aayushgrover0802/quadruped-12DOF-ROS-SIM-REAL/README.md

# quadruped_ws

ROS 2 workspace for the quadruped. Everything lives in [`src/QuadPkg`](src/QuadPkg/README.md);
documentation is in [`src/QuadPkg/docs`](src/QuadPkg/docs/README.md).

```bash
cd ~/quadruped_ws && colcon build --packages-select QuadPkg && source install/setup.bash
```
