aayushgrover0802/quadruped-12DOF-ROS-SIM-REAL/servo_log.txt

servo_monitor  [REAL ROBOT (hardware_bridge debug topics)]   00:09:39
controller state: STAND   motors enabled: False   battery: 11.2 V
last msg  /joint_command  0.0s ago | /debug/servo_command  0.1s ago | /debug/servo_feedback  0.1s ago | /joint_states  0.0s ago
!! NOT SENDING: motors OFF (press M in teleop)

joint        id   ctrl°   sent° ticks> <ticks   meas°   err°  load%  °C     V  flags
------------------------------------------------------------------------------------
FL_HipRoll    3    +0.0       -      -   2096    +0.0      -     -4  37  11.2  TQ0
FL_ThighP     2    -0.0       -      -   2208    +0.0      -     -5  45  11.1  TQ0
FL_KneeP      1    +0.0       -      -   2006    +0.0      -     +5  41  11.2  TQ0
FR_HipRoll    6    +0.0       -      -   1994    +0.0      -     +4  38  11.1  TQ0
FR_ThighP     5    -0.0       -      -   1924    -0.0      -     +7  36  11.2  TQ0
FR_KneeP      4    +0.0       -      -   2212    -0.0      -     +0  38  11.1  TQ0
BL_HipRoll    9    +0.0       -      -   2025    -0.0      -     +6  37  11.2  TQ0
BL_ThighP     8    -0.0       -      -   2341    +0.0      -     -7  37  11.2  TQ0
BL_KneeP      7    +0.0       -      -   2060    +0.0      -     +3  36  11.1  TQ0
BR_HipRoll   12    +0.0       -      -   2059    -0.0      -     -6  38  11.2  TQ0
BR_ThighP    11    -0.0       -      -   1783    -0.1      -     +6  45  11.1  TQ0
BR_KneeP     10    +0.0       -      -   2000    -0.0      -     -3  39  11.1  TQ0

(Ctrl-C to quit)
servo_monitor  [REAL ROBOT (hardware_bridge debug topics)]   00:09:40
controller state: STAND   motors enabled: False   battery: 11.2 V
last msg  /joint_command  0.0s ago | /debug/servo_command  0.1s ago | /debug/servo_feedback  0.1s ago | /joint_states  0.0s ago
!! NOT SENDING: motors OFF (press M in teleop)

joint        id   ctrl°   sent° ticks> <ticks   meas°   err°  load%  °C     V  flags
------------------------------------------------------------------------------------
FL_HipRoll    3    +0.0       -      -   2096    +0.0      -     -4  37  11.2  TQ0
FL_ThighP     2    -0.0       -      -   2208    +0.0      -     -5  45  11.1  TQ0
FL_KneeP      1    +0.0       -      -   2006    +0.0      -     +5  41  11.2  TQ0
FR_HipRoll    6    +0.0       -      -   1994    +0.0      -     +4  38  11.1  TQ0
FR_ThighP     5    -0.0       -      -   1924    -0.0      -     +7  36  11.2  TQ0
FR_KneeP      4    +0.0       -      -   2212    -0.0      -     +0  38  11.2  TQ0
BL_HipRoll    9    +0.0       -      -   2025    -0.0      -     +6  37  11.2  TQ0
BL_ThighP     8    -0.0       -      -   2341    +0.0      -     -7  37  11.2  TQ0
BL_KneeP      7    +0.0       -      -   2060    +0.0      -     +3  36  11.1  TQ0
BR_HipRoll   12    +0.0       -      -   2059    -0.0      -     -6  38  11.2  TQ0
BR_ThighP    11    -0.0       -      -   1783    -0.1      -     +6  45  11.1  TQ0
BR_KneeP     10    +0.0       -      -   2000    -0.0      -     -3  39  11.1  TQ0

(Ctrl-C to quit)
servo_monitor  [REAL ROBOT (hardware_bridge debug topics)]   00:09:41
controller state: STAND   motors enabled: False   battery: 11.2 V
last msg  /joint_command  0.0s ago | /debug/servo_command  0.1s ago | /debug/servo_feedback  0.1s ago | /joint_states  0.0s ago
!! NOT SENDING: motors OFF (press M in teleop)

joint        id   ctrl°   sent° ticks> <ticks   meas°   err°  load%  °C     V  flags
------------------------------------------------------------------------------------
FL_HipRoll    3    +0.0       -      -   2096    +0.0      -     -4  37  11.2  TQ0
FL_ThighP     2    -0.0       -      -   2208    +0.0      -     -5  45  11.1  TQ0
FL_KneeP      1    +0.0       -      -   2006    +0.0      -     +5  41  11.1  TQ0
FR_HipRoll    6    +0.0       -      -   1994    +0.0      -     +4  38  11.1  TQ0
FR_ThighP     5    -0.0       -      -   1924    -0.0      -     +7  36  11.2  TQ0
FR_KneeP      4    +0.0       -      -   2212    -0.0      -     +0  38  11.2  TQ0
BL_HipRoll    9    +0.0       -      -   2025    -0.0      -     +6  37  11.2  TQ0
BL_ThighP     8    -0.0       -      -   2341    +0.0      -     -7  37  11.2  TQ0
BL_KneeP      7    +0.0       -      -   2060    +0.0      -     +3  36  11.2  TQ0
BR_HipRoll   12    +0.0       -      -   2059    -0.0      -     -6  38  11.2  TQ0
BR_ThighP    11    -0.0       -      -   1783    -0.1      -     +6  45  11.1  TQ0
BR_KneeP     10    +0.0       -      -   2000    -0.0      -     -3  39  11.1  TQ0

(Ctrl-C to quit)
servo_monitor  [REAL ROBOT (hardware_bridge debug topics)]   00:09:42
controller state: STAND   motors enabled: False   battery: 11.1 V
last msg  /joint_command  0.0s ago | /debug/servo_command  0.1s ago | /debug/servo_feedback  0.1s ago | /joint_states  0.0s ago
!! NOT SENDING: motors OFF (press M in teleop)

joint        id   ctrl°   sent° ticks> <ticks   meas°   err°  load%  °C     V  flags
------------------------------------------------------------------------------------
FL_HipRoll    3    +0.0       -      -   2096    +0.0      -     -4  37  11.2  TQ0
FL_ThighP     2    -0.0       -      -   2208    +0.0      -     -5  45  11.1  TQ0
FL_KneeP      1    +0.0       -      -   2006    +0.0      -     +5  41  11.1  TQ0
FR_HipRoll    6    +0.0       -      -   1994    +0.0      -     +4  38  11.1  TQ0
FR_ThighP     5    -0.0       -      -   1924    -0.0      -     +7  37  11.2  TQ0
FR_KneeP      4    +0.0       -      -   2212    -0.0      -     +0  38  11.1  TQ0
BL_HipRoll    9    +0.0       -      -   2025    -0.0      -     +6  37  11.2  TQ0
BL_ThighP     8    -0.0       -      -   2341    +0.0      -     -7  37  11.2  TQ0
BL_KneeP      7    +0.0       -      -   2060    +0.0      -     +3  36  11.2  TQ0
BR_HipRoll   12    +0.0       -      -   2059    -0.0      -     -6  38  11.2  TQ0
BR_ThighP    11    -0.0       -      -   1783    -0.1      -     +6  45  11.1  TQ0
BR_KneeP     10    +0.0       -      -   2000    -0.0      -     -3  39  11.1  TQ0

(Ctrl-C to quit)
servo_monitor  [REAL ROBOT (hardware_bridge debug topics)]   00:09:43
controller state: STAND   motors enabled: True   battery: 11.1 V
last msg  /joint_command  0.0s ago | /debug/servo_command  0.1s ago | /debug/servo_feedback  0.1s ago | /joint_states  0.0s ago

joint        id   ctrl°   sent° ticks> <ticks   meas°   err°  load%  °C     V  flags
------------------------------------------------------------------------------------
FL_HipRoll    3    +0.0    +0.0   2096   2095    -0.1   +0.1     +0  37  11.2  
FL_ThighP     2    -0.0    -0.0   2208   2207    -0.1   +0.1     +0  45  11.2  
FL_KneeP      1    +0.0    +0.0   2006   2006    +0.0   +0.0     +0  41  11.2  
FR_HipRoll    6    +0.0    +0.0   1994   1994    +0.0   +0.0     +0  38  11.2  
FR_ThighP     5    -0.0    -0.0   1924   1927    -0.3   +0.2     +3  36  11.3  
FR_KneeP      4    +0.0    +0.0   2212   2212    -0.0   +0.0     +0  38  11.2  
BL_HipRoll    9    +0.0    +0.0   2025   2027    -0.2   +0.2     +2  37  11.3  
BL_ThighP     8    -0.0    -0.0   2341   2339    -0.2   +0.1     -2  37  11.2  
BL_KneeP      7    +0.0    +0.0   2060   2060    +0.0   +0.0     +0  36  11.2  
BR_HipRoll   12    +0.0    +0.0   2059   2058    +0.1   -0.1     +0  38  11.3  
BR_ThighP    11    -0.0    -0.0   1782   1785    -0.3   +0.2     +3  45  11.2  
BR_KneeP     10    +0.0    +0.0   2000   1999    +0.1   -0.1     +0  39  11.2  

(Ctrl-C to quit)
servo_monitor  [REAL ROBOT (hardware_bridge debug topics)]   00:09:44
controller state: STAND   motors enabled: True   battery: 11.2 V
last msg  /joint_command  0.0s ago | /debug/servo_command  0.1s ago | /debug/servo_feedback  0.1s ago | /joint_states  0.0s ago

joint        id   ctrl°   sent° ticks> <ticks   meas°   err°  load%  °C     V  flags
------------------------------------------------------------------------------------
FL_HipRoll    3    +0.0    +0.0   2096   2095    -0.1   +0.1     +0  37  11.2  
FL_ThighP     2    -0.0    -0.0   2208   2207    -0.1   +0.1     +0  45  11.2  
FL_KneeP      1    +0.0    +0.0   2006   2006    +0.0   +0.0     +0  41  11.2  
FR_HipRoll    6    +0.0    +0.0   1994   1994    +0.0   +0.0     +0  38  11.2  
FR_ThighP     5    -0.0    -0.0   1924   1927    -0.3   +0.2     +3  36  11.3  
FR_KneeP      4    +0.0    +0.0   2212   2212    -0.0   +0.0     +0  38  11.2  
BL_HipRoll    9    +0.0    +0.0   2025   2027    -0.2   +0.2     +2  37  11.3  
BL_ThighP     8    -0.0    -0.0   2341   2339    -0.2   +0.1     -2  37  11.2  
BL_KneeP      7    +0.0    +0.0   2060   2060    +0.0   +0.0     +0  36  11.2  
BR_HipRoll   12    +0.0    +0.0   2059   2058    +0.1   -0.1     +0  38  11.3  
BR_ThighP    11    -0.0    -0.0   1782   1785    -0.3   +0.2     +3  45  11.2  
BR_KneeP     10    +0.0    +0.0   2000   1999    +0.1   -0.1     +0  38  11.2  

(Ctrl-C to quit)
servo_monitor  [REAL ROBOT (hardware_bridge debug topics)]   00:09:45
controller state: WALK   motors enabled: True   battery: 11.2 V
last msg  /joint_command  0.0s ago | /debug/servo_command  0.1s ago | /debug/servo_feedback  0.1s ago | /joint_states  0.0s ago

joint        id   ctrl°   sent° ticks> <ticks   meas°   err°  load%  °C     V  flags
------------------------------------------------------------------------------------
FL_HipRoll    3    +0.0    +0.0   2096   2093    -0.3   +0.3     -3  37  11.0  
FL_ThighP     2    -4.7    -4.5   2156   2174    -3.0   -1.5     +6  45  11.0  SLEW
FL_KneeP      1    +3.7    +1.9   2028   2009    +0.3   +1.7     -5  41  11.0  SLEW
FR_HipRoll    6    +0.0    +0.0   1994   2001    +0.6   -0.6     +6  39  10.9  
FR_ThighP     5    +1.2    +1.2   1910   1932    -0.7   +1.9    +27  36  10.9  
FR_KneeP      4    -0.1    -0.1   2214   2172    +3.5   -3.7    -25  38  10.9  
BL_HipRoll    9    +0.0    +0.0   2025   2031    -0.5   +0.5     +6  37  11.0  
BL_ThighP     8    +1.2    +1.2   2355   2332    -0.8   +2.0    -27  37  11.0  
BL_KneeP      7    -0.2    -0.2   2057   2106    +4.0   -4.3    +27  36  11.0  
BR_HipRoll   12    +0.0    +0.0   2059   2058    +0.1   -0.1     +2  38  11.0  
BR_ThighP    11    -4.7    -4.5   1833   1816    -3.0   -1.5     -7  45  10.9  SLEW
BR_KneeP     10    +3.0    +1.6   1982   1996    +0.3   +1.3     +2  39  11.0  SLEW

(Ctrl-C to quit)
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
BR_HipRoll   12    +0.0    +0.0   2059   2054    +0.4   -0.4     -5  38  11.1  
BR_ThighP    11    -0.0    -0.0   1782   1785    -0.3   +0.2     +3  44  11.0  
BR_KneeP     10    +0.0    +0.0   2000   1981    +1.7   -1.7    -16  39  11.1  

(Ctrl-C to quit)
