aayushgrover0802/quadruped-12DOF-ROS-SIM-REAL/src/QuadPkg/isaac/scenes/.thumbs/256x256/NewQuad.usd.png

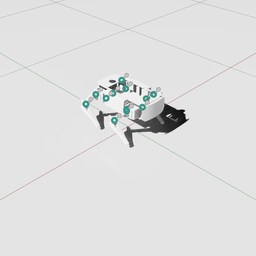
src/QuadPkg/isaac/scenes/.thumbs/256x256/NewQuad.usd.png
