aayushgrover0802/quadruped-12DOF-ROS-SIM-REAL/src/QuadPkg/urdf/meshes/base_link.STL

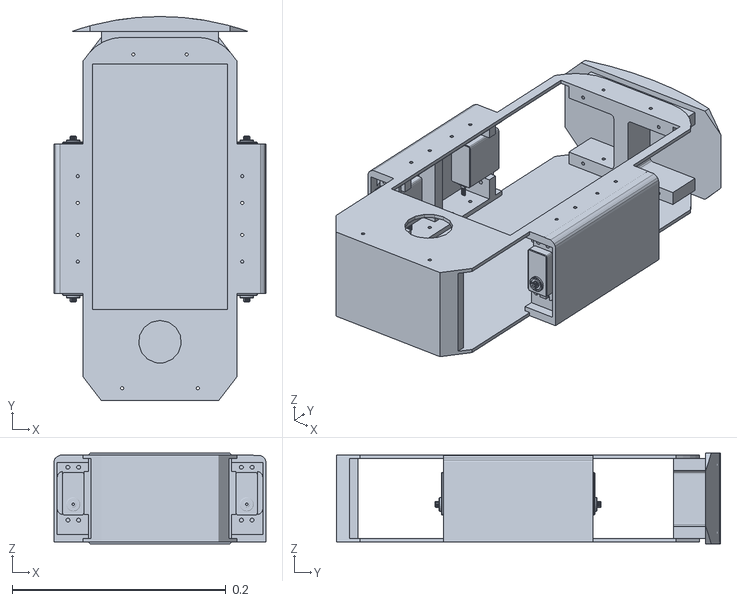
[picture p2: CAD file, 2026-10-12]
src/QuadPkg/urdf/meshes/base_link.STL
0.198 x 0.36 x 0.085
