aayushgrover0802/quadruped-12DOF-ROS-SIM-REAL/src/QuadPkg/urdf/meshes/BL_Thigh.STL

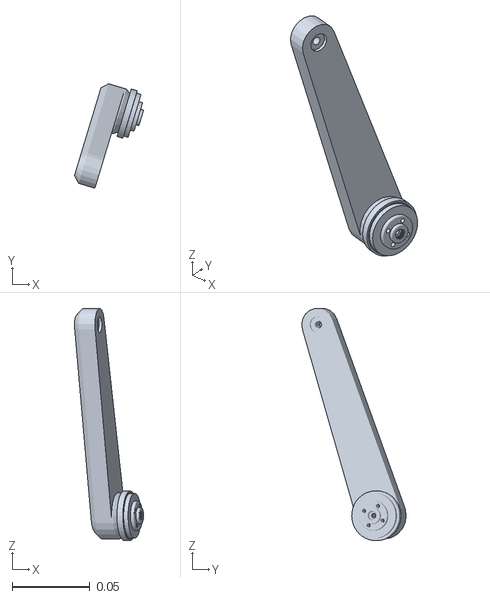
[picture p3: CAD file, 2026-10-12]
src/QuadPkg/urdf/meshes/BL_Thigh.STL
0.0446 x 0.0674 x 0.15
