aayushgrover0802/quadruped-12DOF-ROS-SIM-REAL/src/QuadPkg/urdf/meshes/BR_Hip.STL

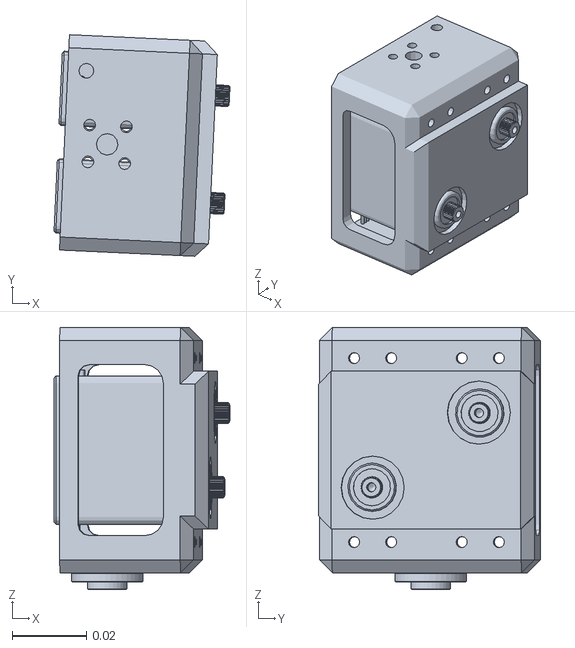
[picture p4: CAD file, 2026-10-12]
src/QuadPkg/urdf/meshes/BR_Hip.STL
0.0473 x 0.0596 x 0.0705
