aayushgrover0802/quadruped-12DOF-ROS-SIM-REAL/src/QuadPkg/urdf/meshes/FL_Thigh.STL

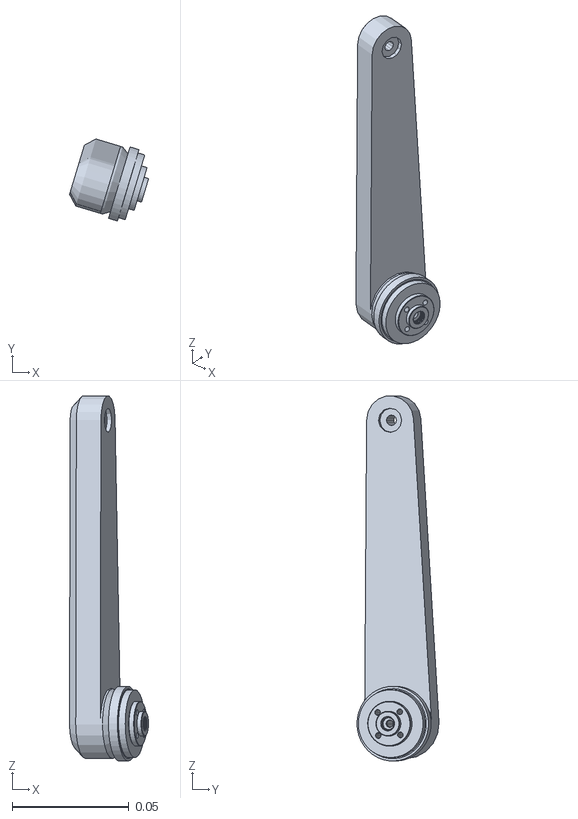
[picture p5: CAD file, 2026-10-12]
src/QuadPkg/urdf/meshes/FL_Thigh.STL
0.0338 x 0.0351 x 0.156
