aayushgrover0802/quadruped-12DOF-ROS-SIM-REAL/src/QuadPkg/urdf/meshes/FR_Knee.STL

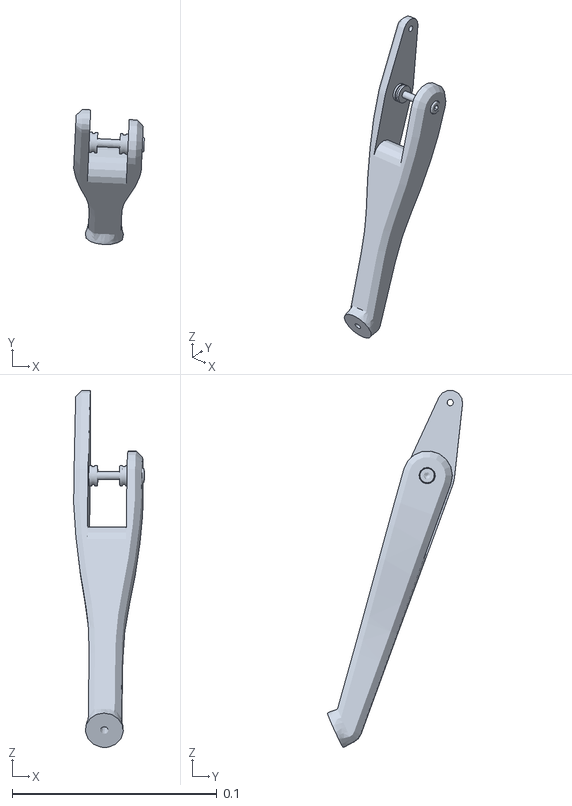
[picture p6: CAD file, 2026-10-12]
src/QuadPkg/urdf/meshes/FR_Knee.STL
0.0345 x 0.066 x 0.174
