aayushgrover0802/quadruped-12DOF-ROS-SIM-REAL/src/QuadPkg/urdf/meshes/BR_Foot.STL

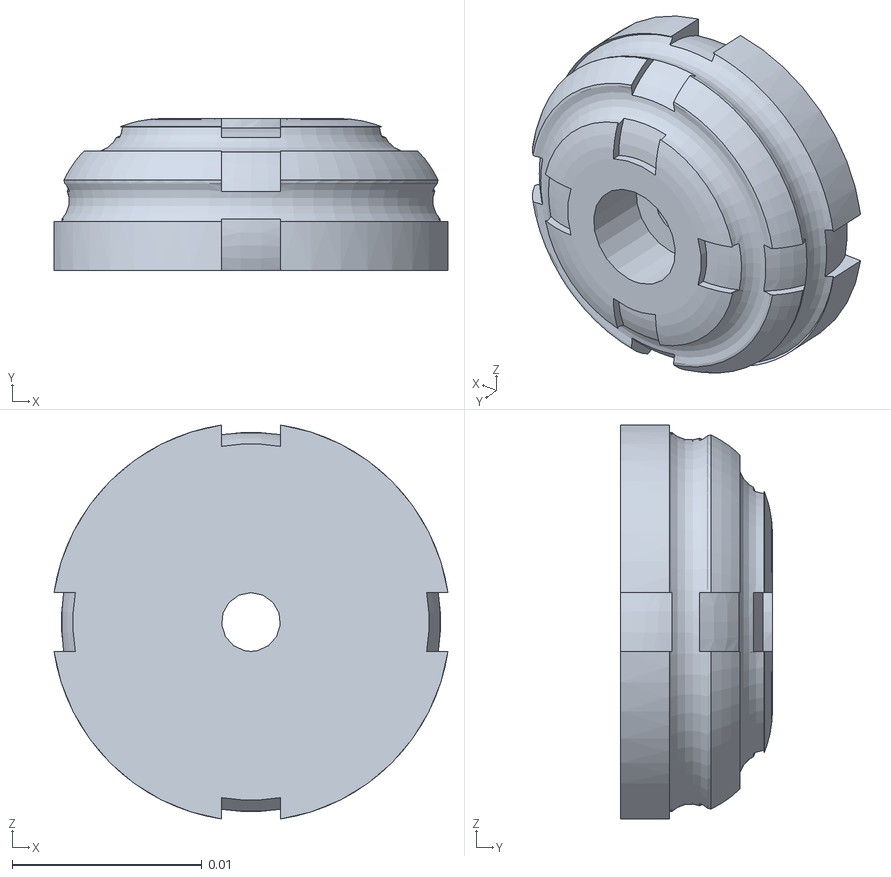
[picture p7: CAD file, 2026-10-12]
src/QuadPkg/urdf/meshes/BR_Foot.STL
0.0208 x 0.008 x 0.0208
