aayushgrover0802/quadruped-12DOF-ROS-SIM-REAL/src/QuadPkg/urdf/meshes/FL_Hip.STL

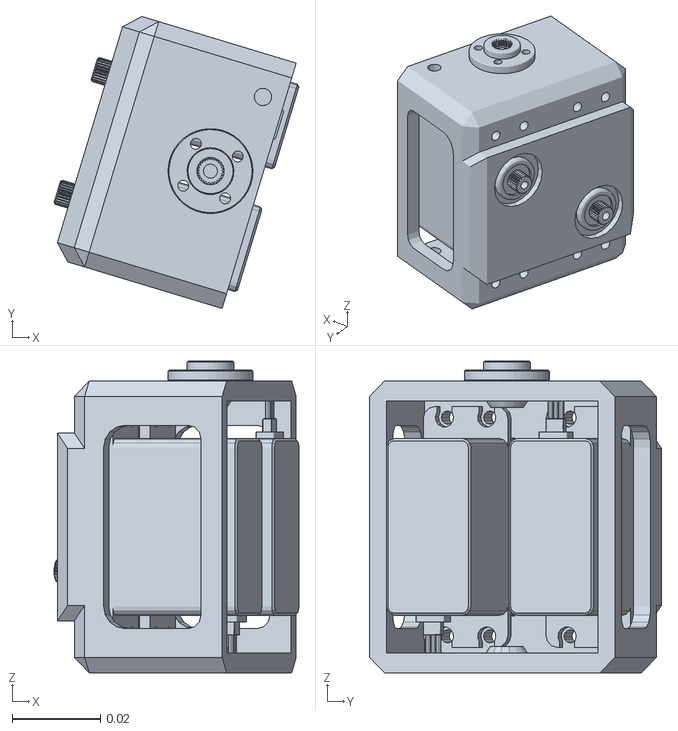
[picture p8: CAD file, 2026-10-12]
src/QuadPkg/urdf/meshes/FL_Hip.STL
0.0554 x 0.0661 x 0.0705
