aayushgrover0802/quadruped-12DOF-ROS-SIM-REAL/src/QuadPkg/urdf/meshes/FR_Foot.STL

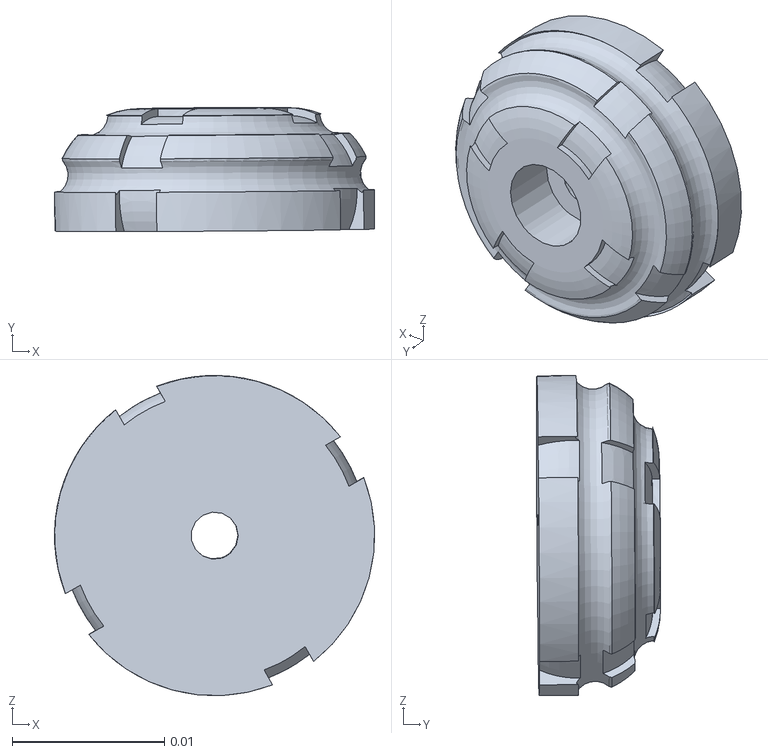
[picture p9: CAD file, 2026-10-12]
src/QuadPkg/urdf/meshes/FR_Foot.STL
0.021 x 0.00815 x 0.021
