aayushgrover0802/quadruped-12DOF-ROS-SIM-REAL/src/QuadPkg/urdf/meshes/BR_Knee.STL

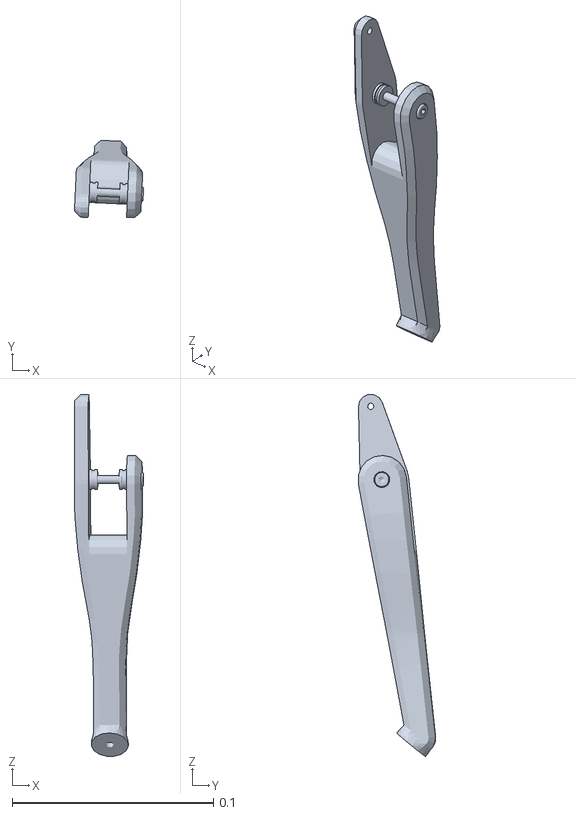
[picture p10: CAD file, 2026-10-12]
src/QuadPkg/urdf/meshes/BR_Knee.STL
0.0344 x 0.0384 x 0.18
