aayushgrover0802/quadruped-12DOF-ROS-SIM-REAL/src/QuadPkg/urdf/meshes/BR_Thigh.STL

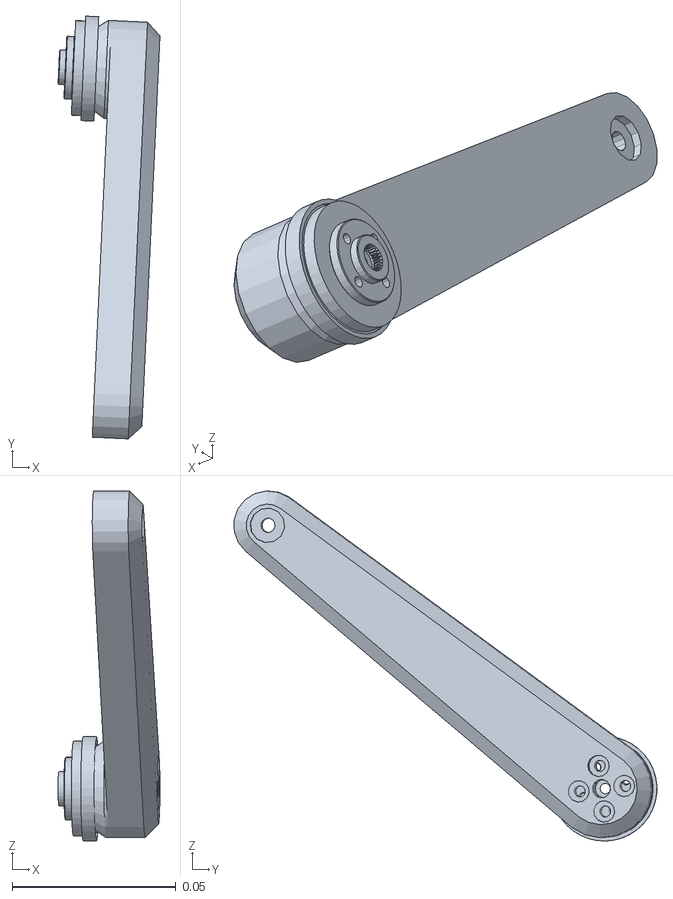
[picture p11: CAD file, 2026-10-12]
src/QuadPkg/urdf/meshes/BR_Thigh.STL
0.0312 x 0.129 x 0.107
