aayushgrover0802/quadruped-12DOF-ROS-SIM-REAL/src/QuadPkg/urdf/meshes/BL_Hip.STL

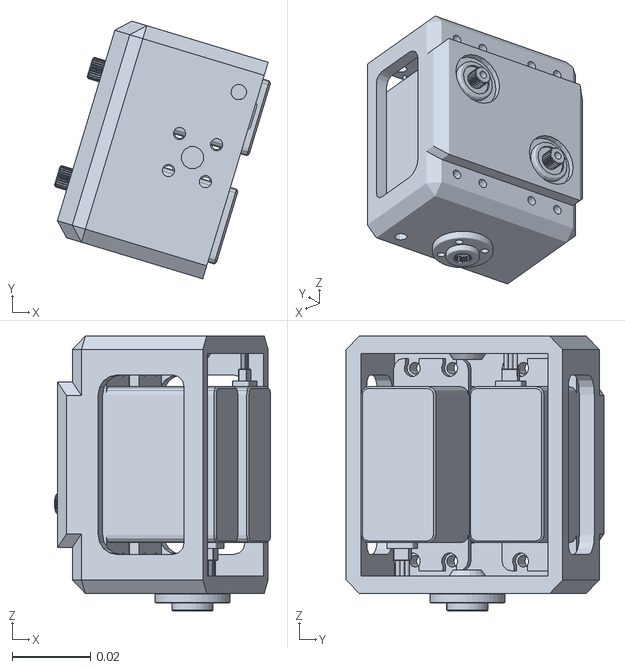
[picture p12: CAD file, 2026-10-12]
src/QuadPkg/urdf/meshes/BL_Hip.STL
0.0554 x 0.0661 x 0.0705
