aayushgrover0802/quadruped-12DOF-ROS-SIM-REAL/src/QuadPkg/urdf/meshes/FL_Knee.STL

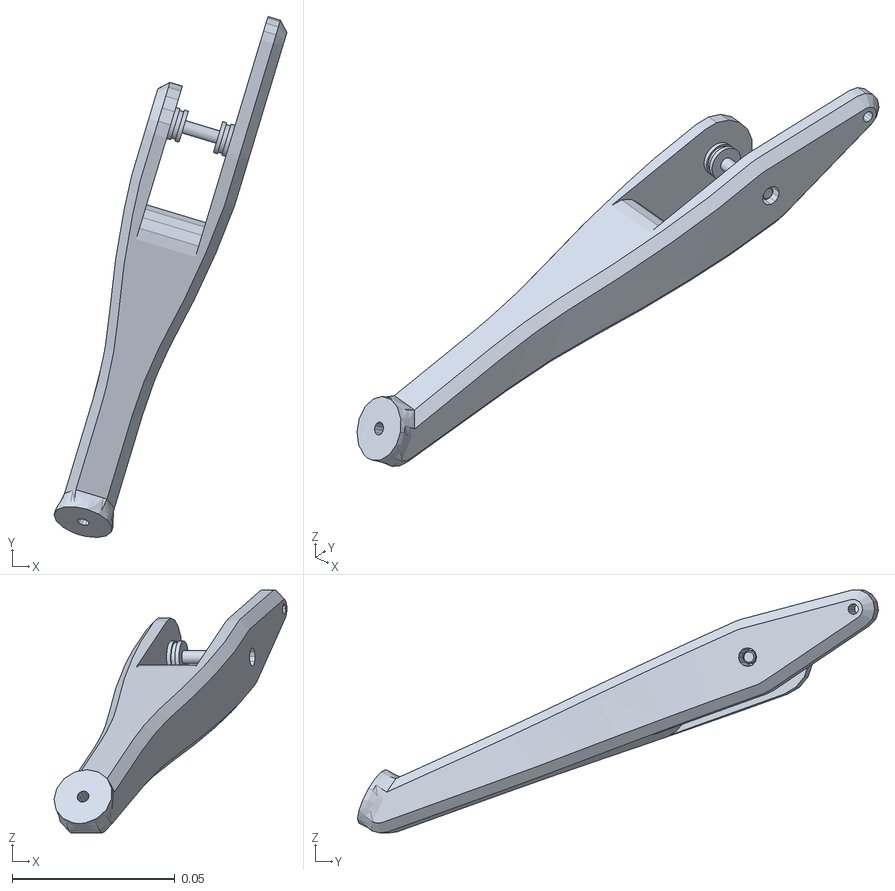
[picture p13: CAD file, 2026-10-12]
src/QuadPkg/urdf/meshes/FL_Knee.STL
0.0716 x 0.16 x 0.0747
