aayushgrover0802/quadruped-12DOF-ROS-SIM-REAL/src/QuadPkg/urdf/meshes/BL_Knee.STL

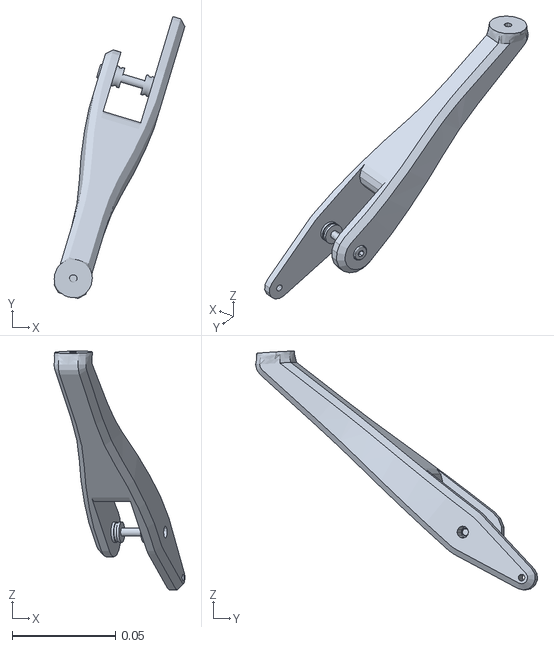
[picture p14: CAD file, 2026-10-12]
src/QuadPkg/urdf/meshes/BL_Knee.STL
0.0633 x 0.137 x 0.116
