aayushgrover0802/quadruped-12DOF-ROS-SIM-REAL/src/QuadPkg/urdf/meshes/FR_Thigh.STL

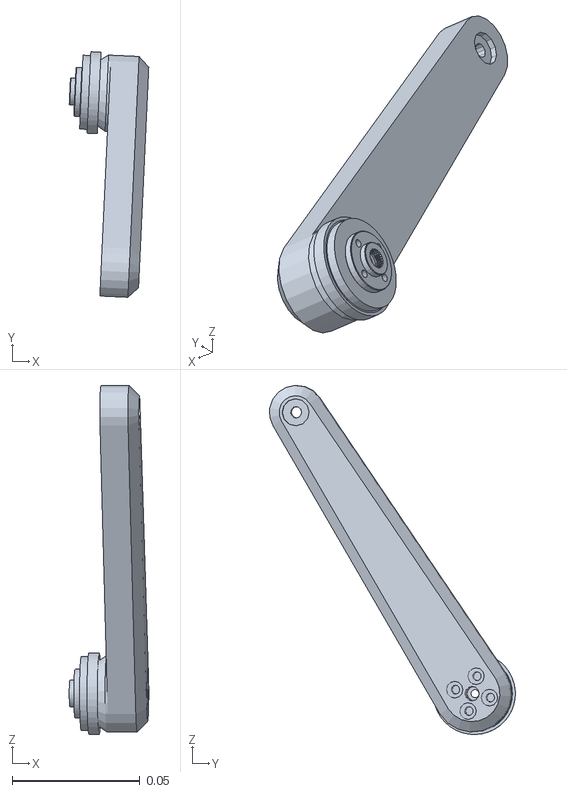
[picture p15: CAD file, 2026-10-12]
src/QuadPkg/urdf/meshes/FR_Thigh.STL
0.0312 x 0.0962 x 0.137
