aayushgrover0802/quadruped-12DOF-ROS-SIM-REAL/(list of files, cad)

Other CAD files:
src/QuadPkg/urdf/meshes/FR_Hip.STL
src/QuadPkg/urdf/meshes/BL_Foot.STL
src/QuadPkg/urdf/meshes/FL_Foot.STL
