aayushgrover0802/quadruped-12DOF-ROS-SIM-REAL/src/QuadPkg/firmware/esp32_servo_bridge/esp32_servo_bridge.ino

/*
 * esp32_servo_bridge  --  Waveshare "Servo Driver with ESP32" <-> Jetson relay
 *
 * All the code is in servo_bridge.cpp (same folder). Arduino IDE compiles it
 * automatically together with this file -- just open THIS file and press Upload.
 *
 * Board: "ESP32 Dev Module".   Full instructions: ../README.md
 *
 * (The code lives in a .cpp file on purpose: the Arduino IDE rewrites .ino files
 *  before compiling, and that rewrite trips over some C++; .cpp files are left alone.)
 */
