aayushgrover0802/quadruped-12DOF-ROS-SIM-REAL/(commit log)

2026-10-12 Quadruped ROS 2 workspace: QuadPkg controller, hardware bridge, debug tools, docs
    [BL_Foot.STL, BL_Hip.STL, BL_Knee.STL, BL_Thigh.STL, BR_Foot.STL, BR_Hip.STL, BR_Knee.STL, BR_Thigh.STL]
2026-10-12 command_lead latency compensation, fix false LIM flag in servo_monitor
    [bridge.py, quad_params.yaml]
2026-10-12 Remove command_lead, add lag_meter
    [hardware.yaml]
